seritools/picoram/kicad/picoram.kicad_sch

## KiCad design kicad/picoram.kicad_sch (2023-05-23, an earlier design)

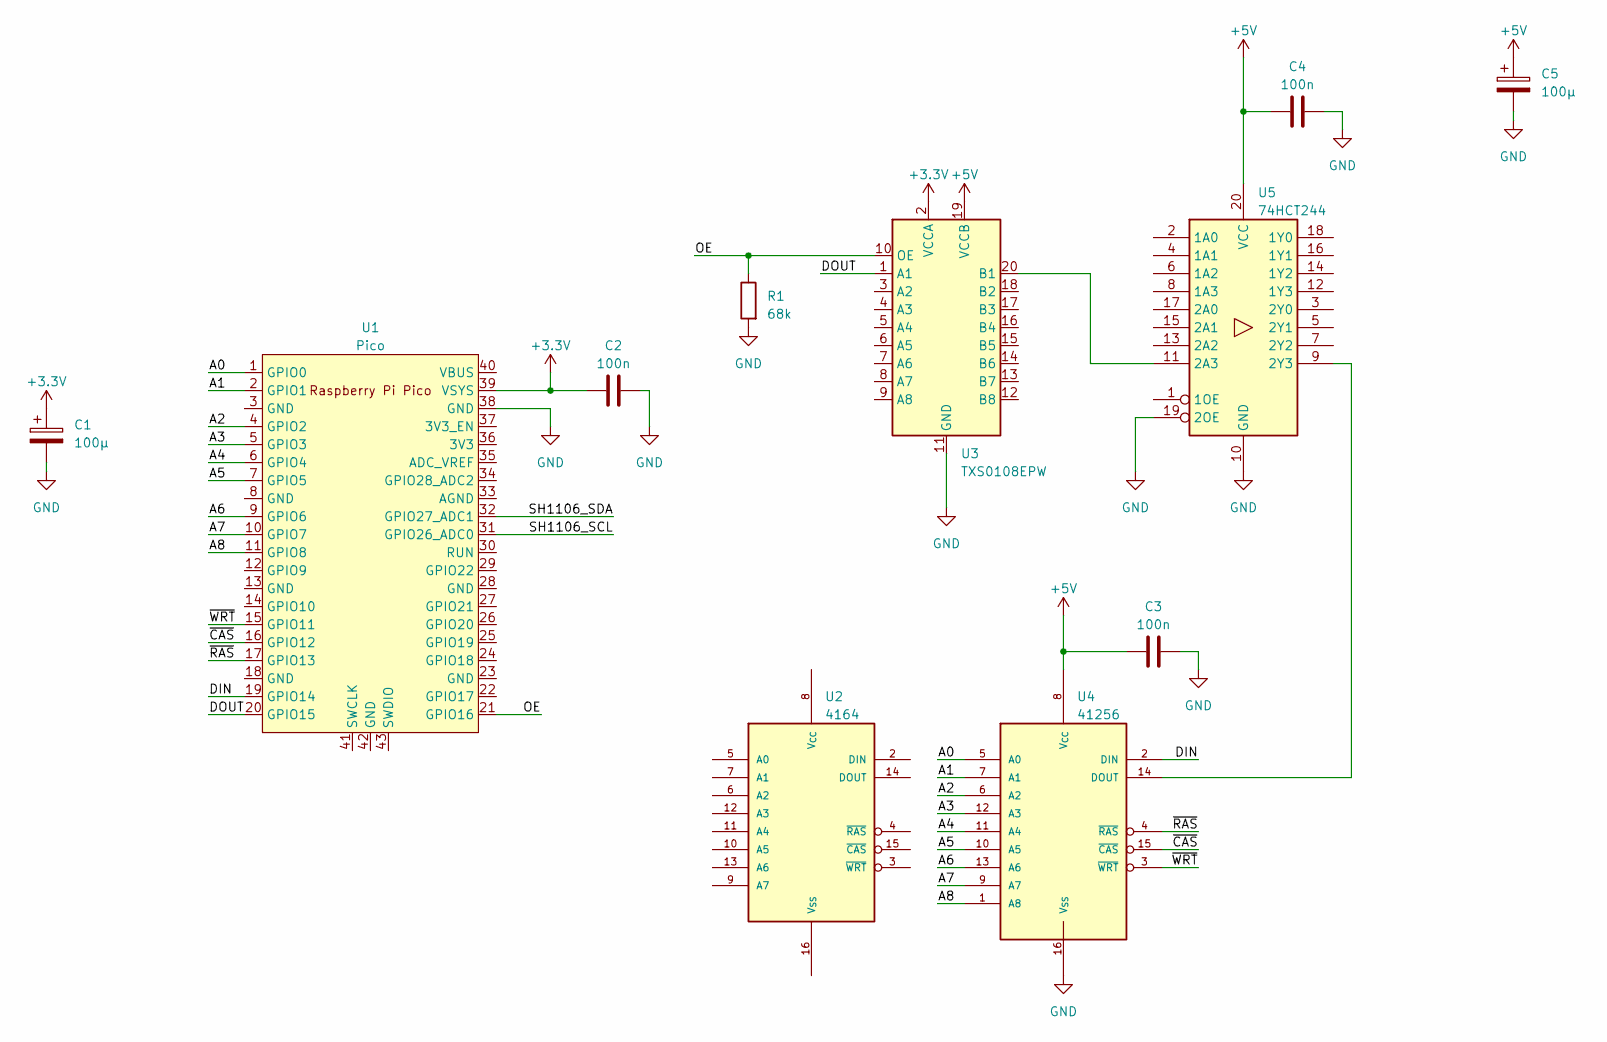
[picture p2: schematic picoram.kicad_sch]

Parts:
C1, C5: 100µ
C2, C3, C4: 100n
R1: 68k
U1: Pico; RPi_Pico_SMD_TH
U2: 4164; DIP-16_W7.62mm
U3: TXS0108EPW; TSSOP-20_4.4x6.5mm_P0.65mm
U4: 41256; DIP-16_W7.62mm
U5: 74HCT244

Connections:
+3.3V: C1.1, C2.1, U1.39 (VSYS), U3.2 (VCCA)
+5V: C3.2, C4.2, C5.1, U3.19 (VCCB), U4.8 (V_{CC}), U5.20 (VCC)
A0: U1.1 (GPIO0), U4.5 (A0)
A1: U1.2 (GPIO1), U4.7 (A1)
A2: U1.4 (GPIO2), U4.6 (A2)
A3: U1.5 (GPIO3), U4.12 (A3)
A4: U1.6 (GPIO4), U4.11 (A4)
A5: U1.7 (GPIO5), U4.10 (A5)
A6: U1.9 (GPIO6), U4.13 (A6)
A7: U1.10 (GPIO7), U4.9 (A7)
A8: U1.11 (GPIO8), U4.1 (A8)
DIN: U1.19 (GPIO14), U4.2 (DIN)
DOUT: U1.20 (GPIO15), U3.1 (A1)
GND: C1.2, C2.2, C3.1, C4.1, C5.2, R1.2, U1.38 (GND), U3.11 (GND), U4.16 (V_{SS}), U5.10 (GND), U5.19 (2OE)
unnamed: U3.20 (B1), U5.11 (2A3)
unnamed: U4.14 (DOUT), U5.9 (2Y3)
OE: R1.1, U1.21 (GPIO16), U3.10 (OE)
SH1106_SCL: U1.31 (GPIO26_ADC0)
SH1106_SDA: U1.32 (GPIO27_ADC1)
~CAS: U1.16 (GPIO12), U4.15 (~CAS)
~RAS: U1.17 (GPIO13), U4.4 (~RAS)
~WRT: U1.15 (GPIO11), U4.3 (~WRT)
