seritools/picoram/(commit log)

2023-05-21 Squashed 'kicad/libraries/KiCad-RP-Pico/' content from commit dc6f9b9
    git-subtree-dir: kicad/libraries/KiCad-RP-Pico
    git-subtree-split: dc6f9b9f213dc36eebce626aa9ee72a333fa0db3
    [Pico.skp, Test.kicad_pcb, Test.kicad_sch]
2023-05-21 Add KiCad files
    [picoram.kicad_pcb, picoram.kicad_sch]
2023-05-23 add additional pulldown to buffer input
    [picoram.kicad_sch]
